t-bucchi/V9968_Cartridge/(notices)

Notices in the files:
pcb/vdp_cartridge_20k_3rd/vdp_cartridge.kicad_pcb:
Copyright 2026 HRA!
